marcosswald/sfero/doc/img/assembly/2023-08-18 11.51.57.jpg

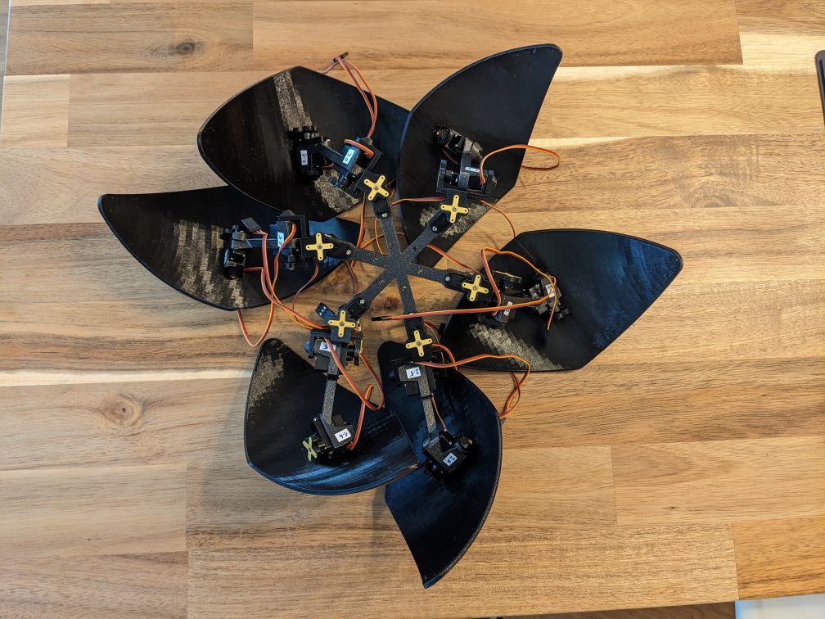
doc/img/assembly/2023-08-18 11.51.57.jpg
