marcosswald/sfero/doc/img/assembly/2023-08-18 11.52.39.jpg

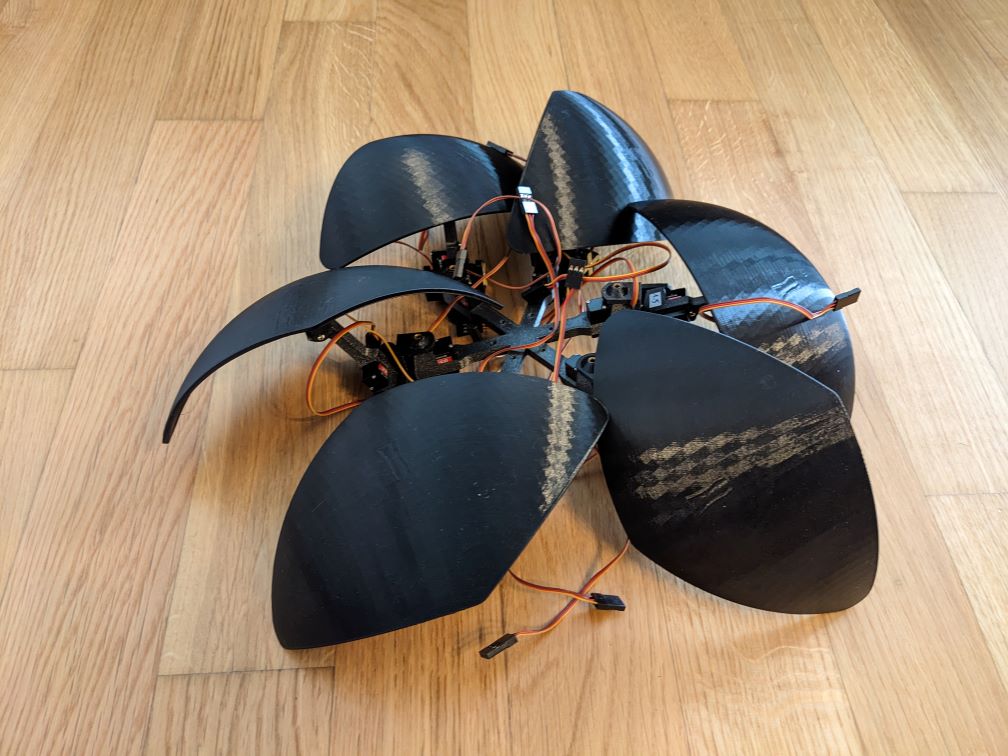
doc/img/assembly/2023-08-18 11.52.39.jpg
