marcosswald/sfero/doc/img/assembly/2023-08-18 17.46.32.jpg

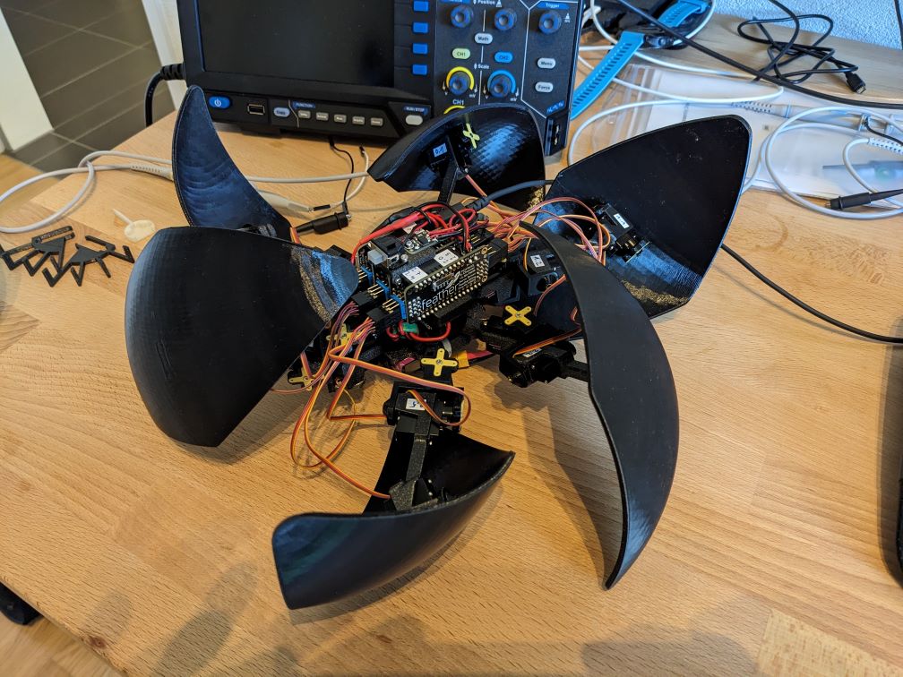
doc/img/assembly/2023-08-18 17.46.32.jpg
