marcosswald/sfero/doc/img/calibration/2023-08-15 17.51.30.jpg

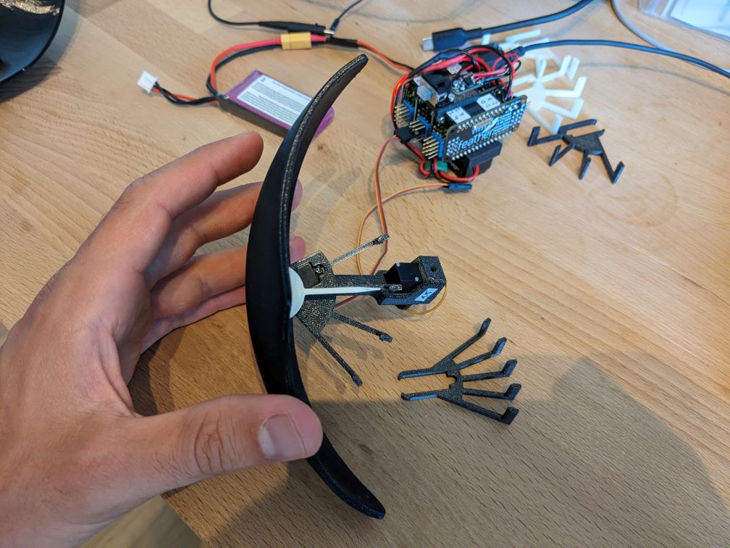
doc/img/calibration/2023-08-15 17.51.30.jpg
