marcosswald/sfero/doc/img/calibration/2023-08-15 18.28.16.jpg

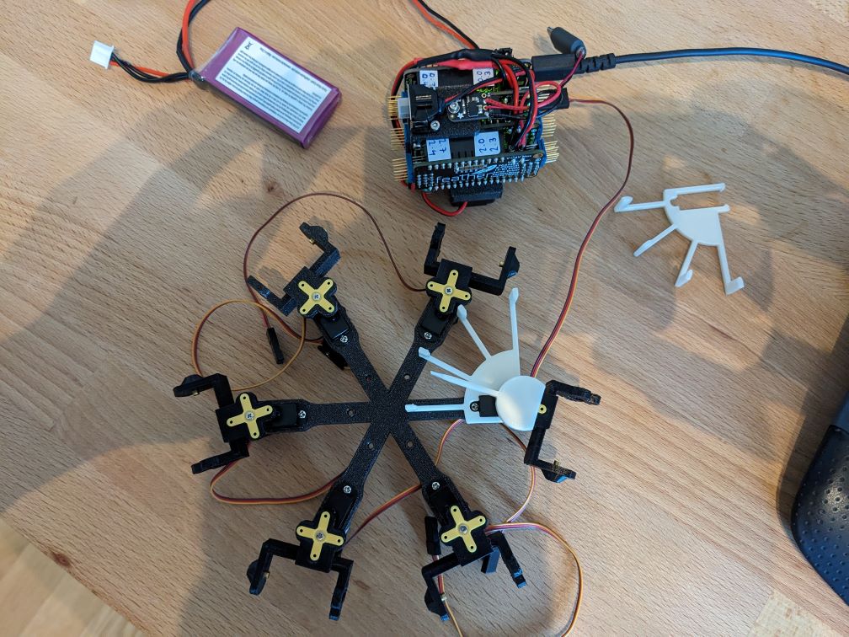
doc/img/calibration/2023-08-15 18.28.16.jpg
