marcosswald/sfero/doc/img/calibration/bad_servo_calib.png

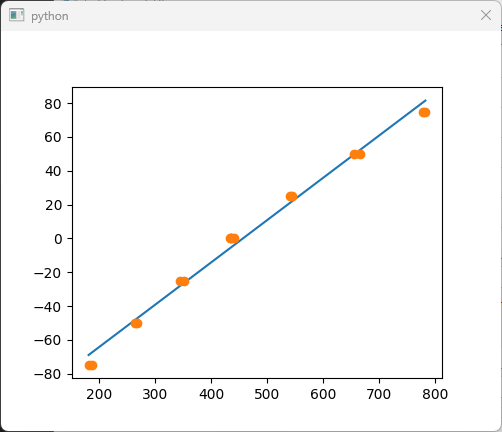
doc/img/calibration/bad_servo_calib.png
