marcosswald/sfero/config/servo_config.yaml

servo_000:
  board_id: 0
  channel: 4
  coefficients:
  - 0.21992095465228753
  - -128.46132763626753
  input_limits:
  - 170
  - 990
  osc_frequency: 24400000
  servo_frequency: 100
servo_001:
  board_id: 0
  channel: 6
  coefficients:
  - 0.2303063107632615
  - -133.1347936897926
  input_limits:
  - 450
  - 920
  osc_frequency: 24400000
  servo_frequency: 100
servo_002:
  board_id: 0
  channel: 1
  coefficients:
  - 0.22038958388737884
  - -133.12952792656432
  input_limits:
  - 240
  - 730
  osc_frequency: 24400000
  servo_frequency: 100
servo_003:
  board_id: 1
  channel: 1
  coefficients:
  - 0.22681920393793628
  - -130.74061375922105
  input_limits:
  - 450
  - 920
  osc_frequency: 26800000
  servo_frequency: 100
servo_004:
  board_id: 2
  channel: 1
  coefficients:
  - 0.21647982117824974
  - -128.12972126000102
  input_limits:
  - 241.0
  - 735.0
  osc_frequency: 26500000
  servo_frequency: 100
servo_005:
  board_id: 1
  channel: 6
  coefficients:
  - 0.21839724669355384
  - -127.53966890476079
  input_limits:
  - 227.0
  - 727.0
  osc_frequency: 26800000
  servo_frequency: 100
servo_006:
  board_id: 2
  channel: 6
  coefficients:
  - 0.2276297794523975
  - -133.7713253536511
  input_limits:
  - 453.0
  - 924.0
  osc_frequency: 26500000
  servo_frequency: 100
servo_007:
  board_id: 0
  channel: 3
  coefficients:
  - 0.23449376803585678
  - -138.55650518818686
  input_limits:
  - 203.0
  - 979.0
  osc_frequency: 24400000
  servo_frequency: 100
servo_008:
  board_id: 1
  channel: 3
  coefficients:
  - 0.22193106819848468
  - -141.25912490833542
  input_limits:
  - 231.0
  - 1050.0
  osc_frequency: 26800000
  servo_frequency: 100
servo_009:
  board_id: 1
  channel: 4
  coefficients:
  - 0.22425182147501013
  - -139.77896347314223
  input_limits:
  - 228.0
  - 1033.0
  osc_frequency: 26800000
  servo_frequency: 100
servo_010:
  board_id: 2
  channel: 3
  coefficients:
  - 0.23258186926909744
  - -142.3982494600049
  input_limits:
  - 227.0
  - 1013.0
  osc_frequency: 26500000
  servo_frequency: 100
servo_011:
  board_id: 2
  channel: 4
  coefficients:
  - 0.22418884578124926
  - -134.0789415800484
  input_limits:
  - 184.0
  - 989.0
  osc_frequency: 26500000
  servo_frequency: 100
servo_012:
  board_id: 0
  channel: 2
  coefficients:
  - 0.23263271456538392
  - -138.32922789844145
  input_limits:
  - 269.0
  - 915.0
  osc_frequency: 24400000
  servo_frequency: 100
servo_013:
  board_id: 2
  channel: 2
  coefficients:
  - 0.2271533264662217
  - -142.42513569432106
  input_limits:
  - 302.0
  - 958.0
  osc_frequency: 26500000
  servo_frequency: 100
servo_014:
  board_id: 2
  channel: 5
  coefficients:
  - 0.21851957682193343
  - -122.22073081121765
  input_limits:
  - 208.0
  - 897.0
  osc_frequency: 26500000
  servo_frequency: 100
servo_015:
  board_id: 1
  channel: 5
  coefficients:
  - 0.23078453705537316
  - -134.01369586134192
  input_limits:
  - 254.0
  - 910.0
  osc_frequency: 26800000
  servo_frequency: 100
servo_016:
  board_id: 0
  channel: 5
  coefficients:
  - 0.22534041539153443
  - -135.17608168299674
  input_limits:
  - 268.0
  - 940.0
  osc_frequency: 24400000
  servo_frequency: 100
servo_017:
  board_id: 1
  channel: 2
  coefficients:
  - 0.2279571063685516
  - -131.06108884276915
  input_limits:
  - 245.0
  - 906.0
  osc_frequency: 26800000
  servo_frequency: 100
