marcosswald/sfero/(commit log)

2023-08-01 first commit of firmware for serial servo controller
2023-08-02 (calibration_gui) first commit
2023-08-06 serial command to set oscillator frequency
    [serial_servo_controller.ino]
2023-08-06 carriage return to improve serial com speed
2023-08-06 plotting and calibration function
2023-08-06 add feature to evaluate x and y from calibrated model
2023-08-07 osc calibration config added
2023-08-09 add servo_config and calib images
    [servo_config.yaml]
2023-08-09 document servo calibration
    [servo_config.yaml]
2023-08-09 update readme and add cad images
2023-08-15 save servo input limits
    [servo_config.yaml]
2023-08-15 servo calibration (lower legs)
    [servo_config.yaml]
2023-08-15 leading zeros for servo name config
    [servo_config.yaml]
2023-08-15 working positioning with calibrated data
2023-08-18 complete servo calibration
    [servo_config.yaml]
